leonardozbreunig/VLC/(commit log)

2016-09-01 Create Assembly Transmissor
2016-09-01 Update Assembly Transmissor
